TheCodeSharman/ToasterControl/front_panel.3mf

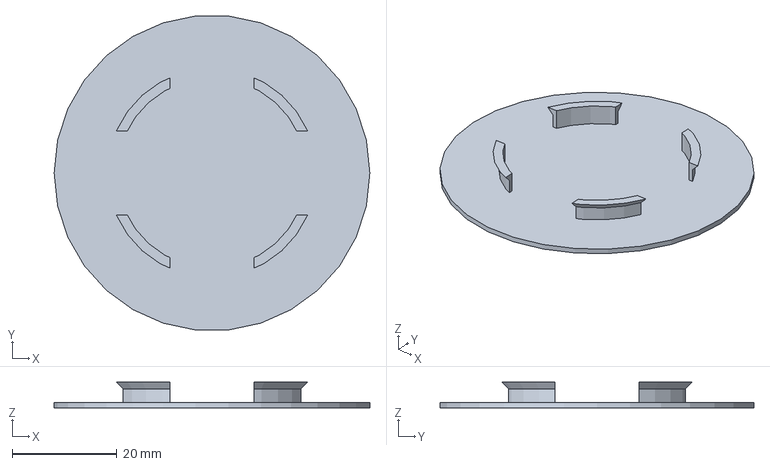
[picture p1: CAD file, 2024-07-13]
front_panel.3mf
60.3 x 60.0 x 4.90 mm
