TheCodeSharman/ToasterControl/enclosure_with_supports.3mf

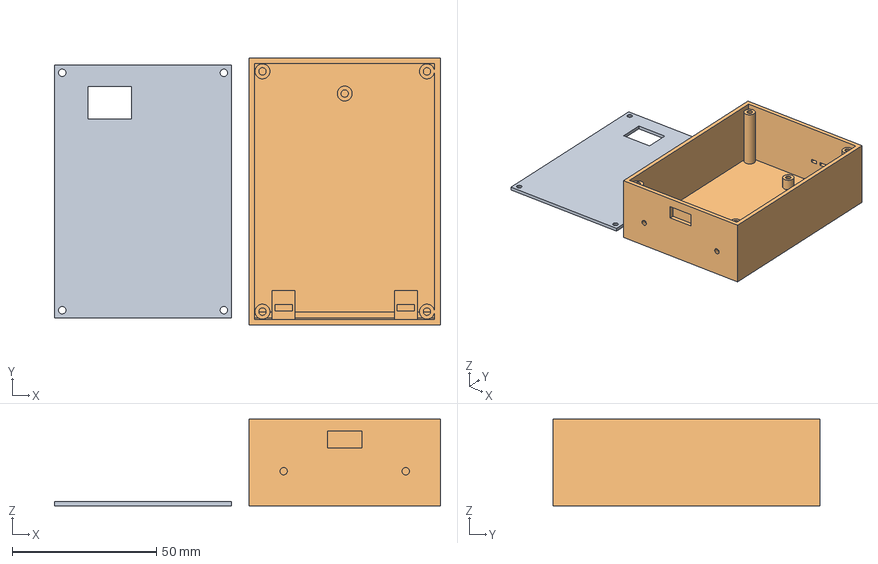
[picture p2: CAD file, 2022-01-06]
enclosure_with_supports.3mf
134.0 x 92.8 x 30.0 mm
