TheCodeSharman/ToasterControl/enclosure_body.3mf

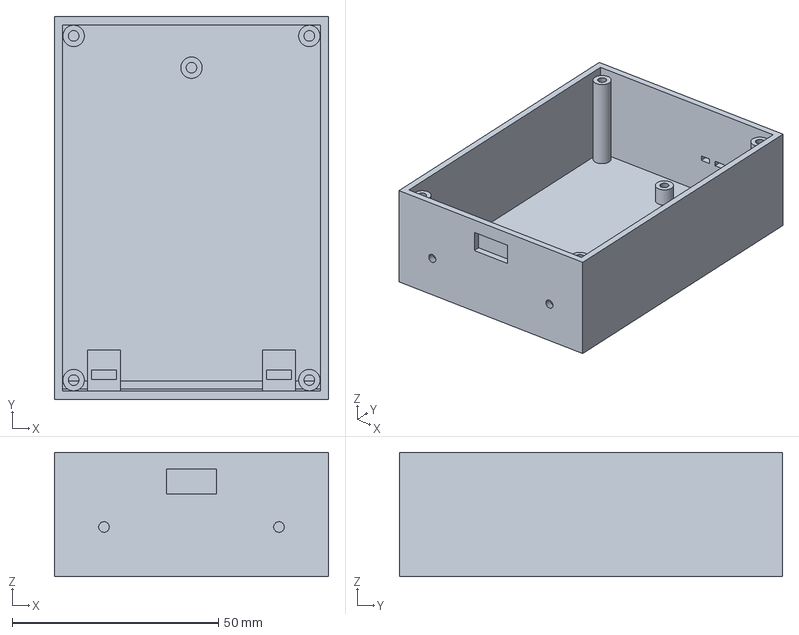
[picture p3: CAD file, 2022-01-01]
enclosure_body.3mf
66.5 x 92.8 x 30.0 mm
