TheCodeSharman/ToasterControl/enclosure_lid.3mf

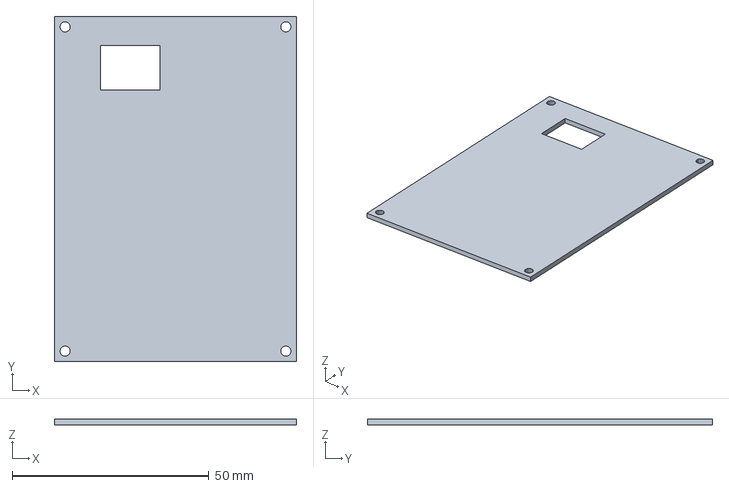
[picture p4: CAD file, 2022-01-01]
enclosure_lid.3mf
61.5 x 87.8 x 1.50 mm
