TheCodeSharman/ToasterControl/(list of files, cad)

Other CAD files:
front_panel.stl
