TheCodeSharman/ToasterControl/hardware/ToasterControl.kicad_pcb

## KiCad design landmetrics_prototype.kicad_sch

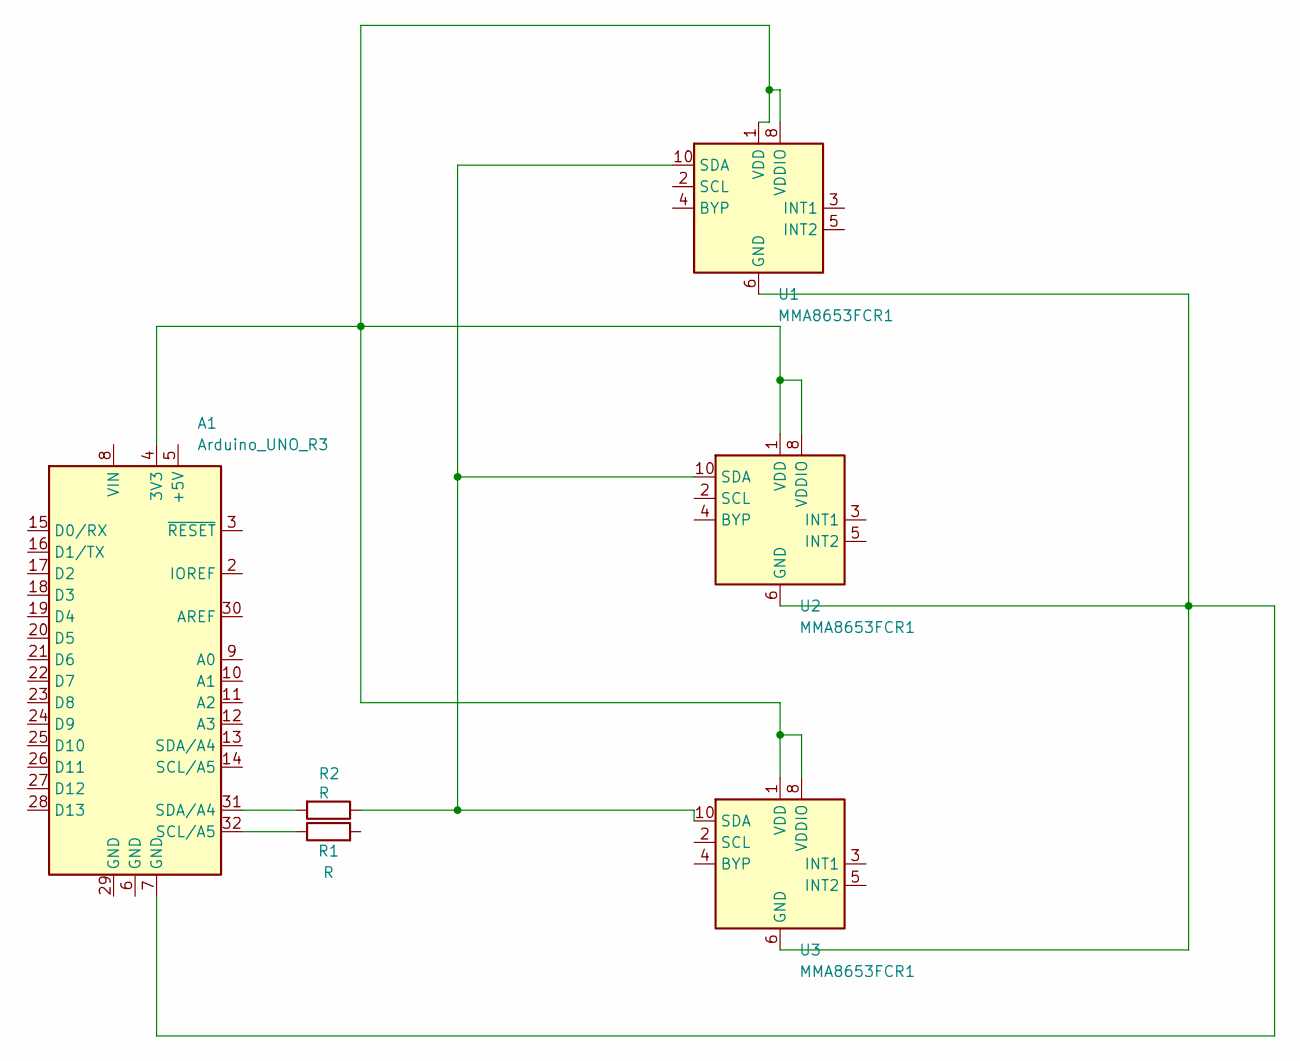
[picture p6: schematic landmetrics_prototype.kicad_sch]

Parts:
A1: Arduino_UNO_R3
R1, R2: R
U1, U2, U3: MMA8653FCR1; DFN-10_2x2mm_P0.4mm

Connections:
unnamed: A1.4 (3V3), U1.1 (VDD), U1.8 (VDDIO), U2.1 (VDD), U2.8 (VDDIO), U3.1 (VDD), U3.8 (VDDIO)
unnamed: A1.7 (GND), U1.6 (GND), U1.7 (GND), U1.9 (GND), U2.6 (GND), U2.7 (GND), U2.9 (GND), U3.6 (GND), U3.7 (GND), U3.9 (GND)
unnamed: A1.31 (SDA/A4), R2.2
unnamed: A1.32 (SCL/A5), R1.1
unnamed: R2.1, U1.10 (SDA), U2.10 (SDA), U3.10 (SDA)
