TheCodeSharman/ToasterControl/include/CommandProcessor.h

#ifndef COMMAND_PROCESSOR_H
#define COMMAND_PROCESSOR_H

#include <Arduino.h>
#include <vector>

#include "GCode.h"
#include "PidController.h"
#include "KTypeProbe.h"
#include "Settings.h"
#include "MultiTask.h"
/*
    Command processor is responsible for recieve bytes from the serial
    port and executing G-Code commands.
*/

class CommandProcessor {
    GCodeParser GCode = GCodeParser();
    Stream& output;
    MultiTask& multitask;

    M105_M155 m105_155;
    M104 m104;
    M997 m997;
    M301 m301;
    M305 m305;
    M500_503 m500_503;
    std::vector<AbstractGCodeCommand*> commands;

    public:
        CommandProcessor(Stream& output, PidController& oven, KTypeProbe& probe, Settings& settings, MultiTask& multitask);

    private:
        void processCommand();

    public:
        void init();
        void addByte(char inChar);
};

#endif
