TheCodeSharman/ToasterControl/src/gcodes/M104.cpp

#include "gcodes/M104.h"

bool M104::match() {
    if ( GCode.HasWord('M') ) {
       if ( (int)GCode.GetWordValue('M') == 104 ) {
            return GCode.HasWord('S');
       }
    }
    return false;
}

void M104::execute() {
    double temp = GCode.GetWordValue('S');
    if ( temp > 0 ) {
        oven.start(temp);
    } else {
        oven.stop();
    }
    output.printf("ok\r\n");
}
