TheCodeSharman/ToasterControl/include/MultiTask.h

#ifndef EVERY_H
#define EVERY_H

#include <Arduino.h>
#include <vector>
#include <functional>

/*
    Keeps track of multiple functions to be called at specified intervals.

    To use declare an instance of Every:

            MultiTask tasks;

        In some initialisation function add some callbacks:

            tasks.every(1000,callbackFunction1);
            tasks.every(500,callbackFunction2);

        Then in the main loop call process():

            tasks.process();

    It's up to the impementor to ensure there is no blocking code and return 
    promptly - otherwise nothing will be called whilst a function is being run.
*/
class MultiTask {
  uint32_t current;

  public:
    class CallbackFunction {
      friend class MultiTask;

      private:
        CallbackFunction( std::function<void()> callback, uint32_t nextCall, uint32_t period )
          : callback(callback), nextCall(nextCall), period(period)  {}

        std::function<void()> callback;
        uint32_t nextCall;
        uint32_t period;
      public:
        uint32_t getPeriod() { return period; }
        void setPeriod( uint32_t period) { this->period = period; }

    };

  private:
    std::vector<CallbackFunction*> callbacks;

  public:

    ~MultiTask() {
      for( CallbackFunction* cb : callbacks ) {
        delete cb;
      }
    }
    /* Add a call back function to be called every time the clock ticks over the 
       specified delay in milliseconds */
    CallbackFunction* every(uint32_t delay, std::function<void()> callback) {
      CallbackFunction* cb = new CallbackFunction(callback, 0, delay);
      callbacks.push_back(cb);
      return cb;
    }

    /* Needs to be called as often as possible */
    void process() {
      current = millis();
      for(CallbackFunction* cb : callbacks ) {
        if ( cb->nextCall < current && cb->period > 0 ) {
          cb->nextCall = current+cb->period;
          cb->callback();
        }
      }
    }
};


#endif
