TheCodeSharman/ToasterControl/(commit log)

2020-09-01 ambient temperature reading
2020-09-08 use raspberrypi compatbile gcc
2020-09-12 use arm compatible gcc
2021-11-06 correctly calculating temperature
2021-11-06 removed external temp offset - need to physically enclose sensor to stabilise ambient temperature
    [main.cpp]
2021-11-06 final calibration values
2021-11-07 interpolate from two measured values to calculate temperature
2021-11-09 decoupling status output from sensor reading
2021-11-09 use tighter types and add accessor for ADC value
    [KTypeProbe.cpp, KTypeProbe.h]
2021-11-09 print ccalibration values in temp status display
2021-12-31 added enclosure
    [enclosure.scad]
2022-01-01 finished enclosure
    [enclosure.scad, enclosure_body.3mf, enclosure_lid.3mf]
2022-01-06 added command processor
    [enclosure_with_supports.3mf]
2022-01-06 added ability to reset into bootloader
    [CommandProcessor.h, main.cpp]
2022-01-06 updated framework
2022-01-06 fix boot into bootloader
    [CommandProcessor.cpp, CommandProcessor.h]
2022-01-07 Refactored KTypeProbe
    Decided to remove the templated default funcions - whilst the code certainly is tighter it seems fairly non idiomatic C++. For the STM32 we're not that concerned about every byte being saved
    in the final binary. Added an abstract superclass so that the PID controller can be decoupled from the particular sensor it is controlling.
    [CommandProcessor.cpp, CommandProcessor.h, KTypeProbe.cpp, KTypeProbe.h, MultiTask.h, main.cpp]
2022-01-07 we were using the wrong GCode for set temperature so siwtch to M104 instead of M105
    [CommandProcessor.cpp, CommandProcessor.h, GCode.h, M104.cpp, M104.h, main.cpp]
2022-01-07 added pid control to oven chamber
2022-01-07 fix typo in comment
    [CommandProcessor.cpp, ControlledDevice.h]
2022-01-07 only poll PID controller every 100 milliseconds
2022-01-07 used correct __asm inline in M997
    [M997.cpp]
2022-01-08 fix wording in comment
    [M997.cpp]
2022-01-08 update comment about __set_MSP() since its actually the code that dereferences a NULL pointer that is the issue with gcc.
    [M997.cpp]
2022-01-08 Remove inline assembly Instead use no-isolate-erroneous-paths-dereference optimizer flag to instruct gcc to not replace NULL pointer deference is undefined instruction trap.
    [M997.cpp]
2022-01-08 and infinite loop to M997 to avoid compiler warning about function returning
    [M997.cpp]
2022-01-08 make it possible to adjust probe calibration
2022-01-08 added ability to tune PID controller
2022-01-08 added M306 command to set probe calibration
2022-01-10 remove autotune Auto tune code wasn't working so removed it in favour of a manual tuning procedure. Reduced the window size on the time based proportional oven chamber to 500ms. Made the internal col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
2022-01-10 changed the oven chamber to use a smaller frequency of pulses.
2022-01-12 fix cold junction reading
    [KTypeProbe.cpp]
2022-01-12 fxi pid controller issues
    [M105_M155.cpp, PidController.cpp]
2022-01-12 fix integer arithemtic in readColdJunction()
    [KTypeProbe.cpp]
2022-01-12 implement own PID code
2024-07-13 increased averaging to 100 samples on error_slope
    [front_panel.3mf, front_panel.scad, front_panel.stl]
2024-07-13 make averages and sample period configurable
2024-07-14 Update PID defaults to more realistic values
2024-07-14 Average error instead of slope
    The intention is that this will give better numeric accuracy and should
    be equivalent to averaging the slopes.
    [PidController.cpp, PidController.h]
2024-07-14 Combine move header files out of include folder
    I find the original sttructure very confusing, some times methods are
    implemented in header files so it doesn't make sense to keep them
    seperate.
    [CommandProcessor.h, ControlledDevice.h, GCode.h, KTypeProbe.h, M104.h, M105_M155.h, M301.h, M305.h]
2024-07-15 Very basic KiCad schematic
    Reverse engineered from the board - looks like quite few dubious design
    decisions here.
    [ToasterControl.kicad_pcb, ToasterControl.kicad_sch]
2024-07-15 Fix precision bug for PidController slope calcs
    Whoops. The templated accumulate function was using ints instead of
    doubles and therefore coercing every thing to integers.
    Changed the `0` to `0.0` fixes the issue!
    [PidController.cpp]
2024-07-20 Change the sample period
    To make the calculated slope steady
2024-07-20 Rest I after calibration
    I foudn that whilst trying to manually tune that if there is a large
    accumulated I and I is made very small it can take a long time for the
    system to settle into a new steady state.
    So to get a better idea of a new tuning just simply reset I to 0
    [PidController.cpp]
2024-07-21 Update DEV-LOG to record last couple of days
2024-07-21 update PID default settings to be reasonable
2024-07-23 Add a comment about scrwing down the probe contacts
